leanmiglio/PPS_MIGLIORETTI2024/VideosProceso/86468744-9982-4b7a-903a-4087c4c9fd52.jpeg

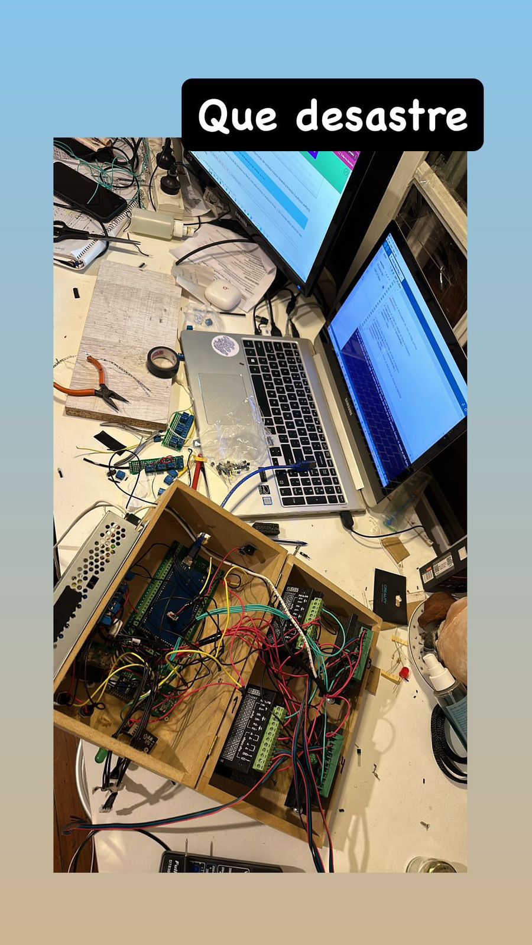
VideosProceso/86468744-9982-4b7a-903a-4087c4c9fd52.jpeg
