leanmiglio/PPS_MIGLIORETTI2024/VideosProceso/c855923a-c1b0-42bb-956e-99e7ce9347d5.jpeg

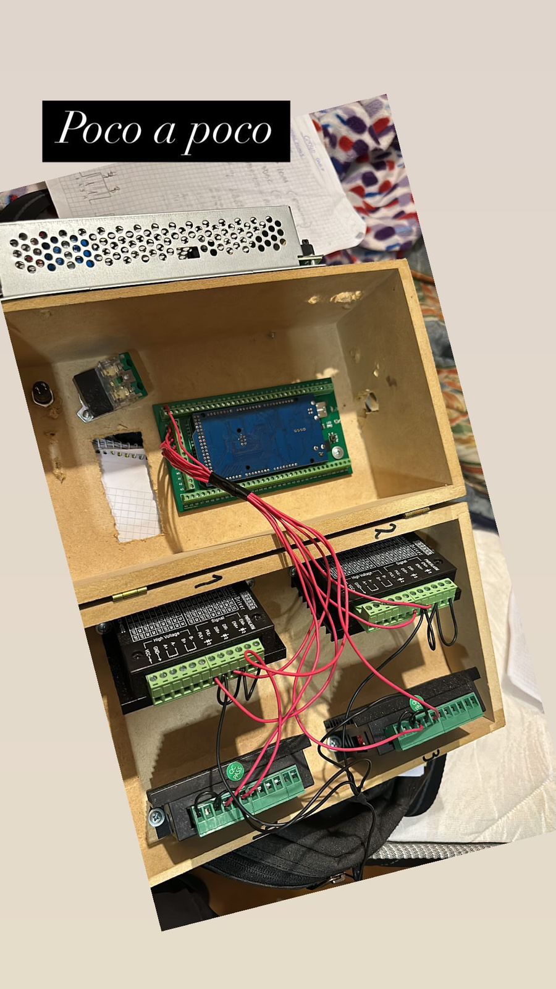
VideosProceso/c855923a-c1b0-42bb-956e-99e7ce9347d5.jpeg
