leanmiglio/PPS_MIGLIORETTI2024/VideosProceso/WhatsApp Image 2024-12-30 at 14.57.31.jpeg

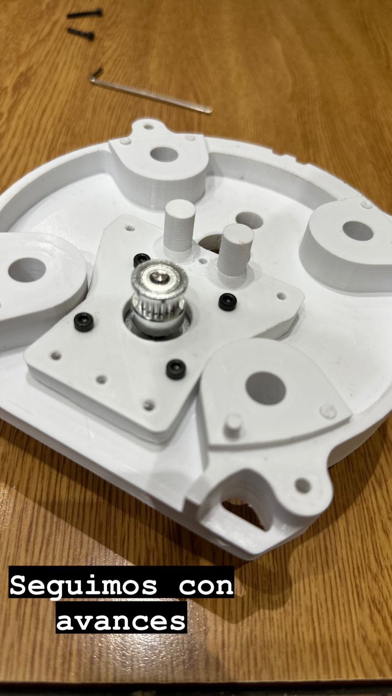
VideosProceso/WhatsApp Image 2024-12-30 at 14.57.31.jpeg
